codewrite/COBHouseLights/img/hardware-top-level.png

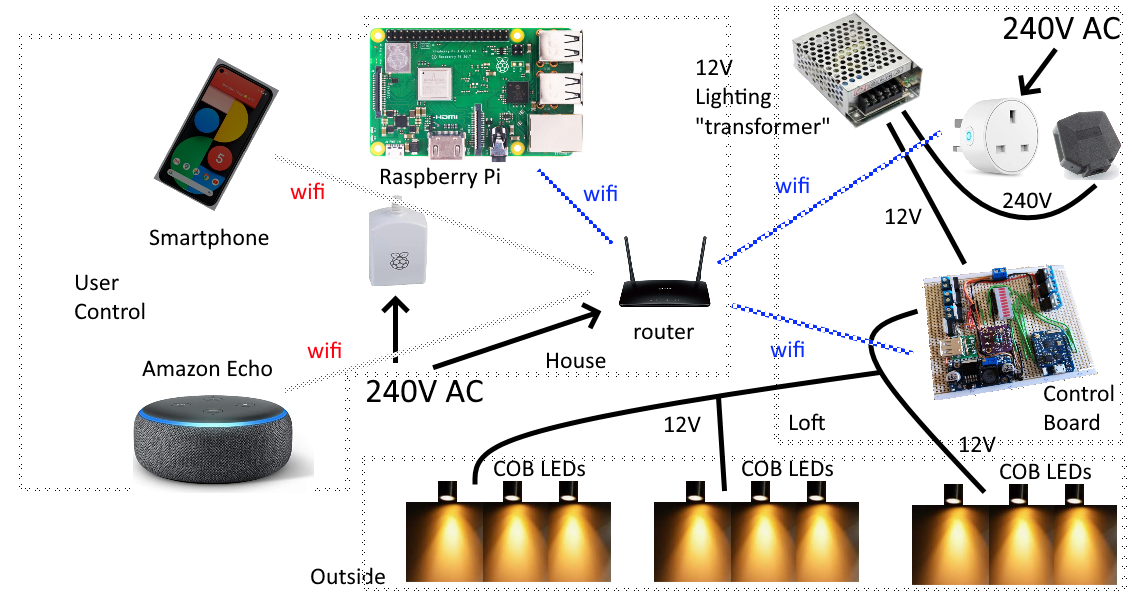
img/hardware-top-level.png
