codewrite/COBHouseLights/img/veroboard-test-setup.jpg

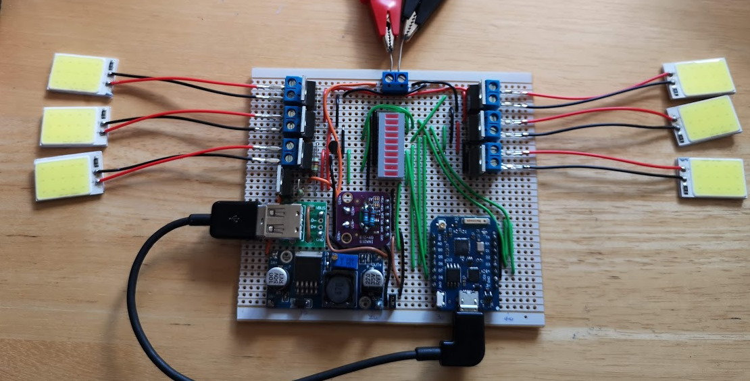
img/veroboard-test-setup.jpg
