codewrite/COBHouseLights/doc/ESP-Links.txt

https://randomnerdtutorials.com/esp32-esp8266-web-server-http-authentication/

>> ESP32 library missing WebServerSecure ?
https://github.com/espressif/arduino-esp32/issues/3902

https://github.com/esp8266/Arduino/tree/master/libraries/ESP8266WebServer/src
https://github.com/espressif/arduino-esp32/tree/master/libraries/WebServer/src

https://github.com/fhessel/esp32_https_server_compat/tree/3c3fe8479af06cc06e8db643acc81501217427bb/src

https://github.com/fhessel/esp32_https_server
https://www.dfrobot.com/blog-1255.html
