codewrite/COBHouseLights/img/veroboard1.jpg

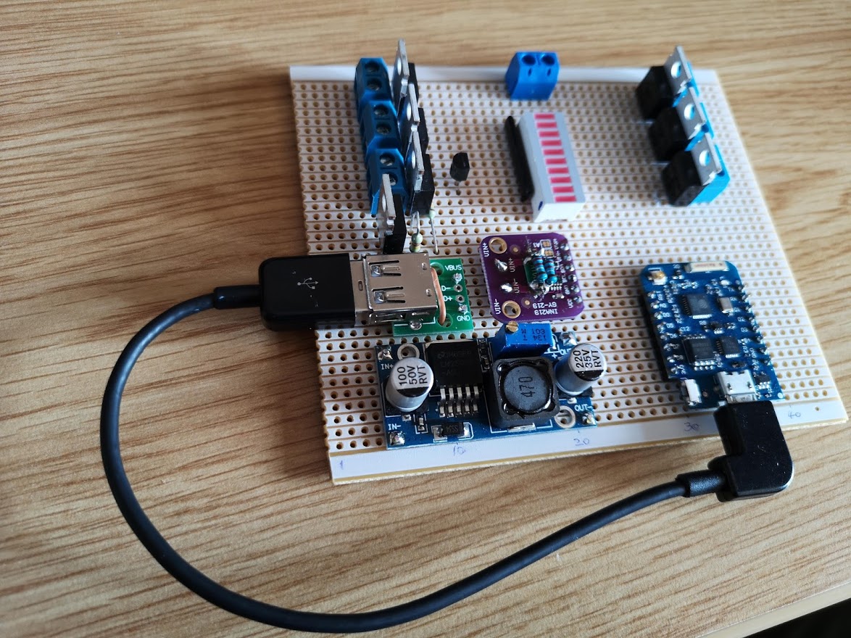
img/veroboard1.jpg
