codewrite/COBHouseLights/arduino/Veroboard-tests.xlsx

USB plugged into PC
 | Supply Voltage | Supply Current | LED1+ | LED1- | LED2+ | LED2- | LED3+ | LED3- | LED4+ | LED4- | LED5+ | LED5- | LED6+ | LED6-
pwr=0 | 12.1 | 0.006 | 0 | 0 | 0 | 0 | 0 | 0 | 0 | 0 | 0 | 0 | 0 | 0
Pwr=1 | 12.1 | 0.006 | 12.1 | 5.15 | 12.1 | 5.15 | 12.1 | 5.15 | 12.1 | 5.15 | 12.1 | 5.15 | 12.1 | 5.15
Voltage drop from rail (mV)
 |  |  | LED1+ | LED1- | LED2+ | LED2- | LED3+ | LED3- | LED4+ | LED4- | LED5+ | LED5- | LED6+ | LED6-
Pwr=1 | 11.95 | 0.191 | 25.2 | 8.4
 | 11.92 | 1.07 | 143.1 | 10 | 142.5 | 9.9 | 140.5 | 10.2 | 145 | 8.6 | 145.6 | 9.2 | 146.2 | 9.4
