codewrite/COBHouseLights/img-src/PChan-Mosfet-driver-redesigned.asc

C1: polcap; 10µ; V=10 Irms=2.21565 Rser=0.055 Lser=0 mfg="KEMET" pn="A700V106M010ATE055" type="Al electrolytic"
D1: zener; BZX84B9V1L
D2: diode; 1N4148
M1: pmos; IRF4905
M2: nmos; 2N7002
R1: res; 4R7
R2: res; 10K
R3: res; 220K
R4: res; 220K
V1: voltage; 12; Rser=1m
V2: voltage; PWL(0 0 1u 3.3 1 3.3 1.000001 0 1.5 0 1.500001 3.3 2 3.3 2.000001 0 2.2 0 2.200001 3.3 7 3.3 7.000001 0 8 0); Rser=10
Named nets: 0, IN, GATE, OUT
.inc irf4905.spi
.tran 8
COB Lights
