codewrite/COBHouseLights/img-src/COBHouseLights.asc

C2: polcap; 10µ; V=25 Irms=50m Rser=1.746 Lser=83.1619n mfg="Würth Elektronik" pn="860010472002 WCAP-ATG8 5x11" type="Al electrolytic"
D1: LED
D2: LED
D3: LED
D4: LED
D5: LED
D6: LED
D7: diode; 1N4148
I1: Connector
I2: Connector
I3: Connector
I4: Connector
I5: Connector
I6: Connector
M1: nmos; 2N7000
M2: pmos; IRF4905
M3: nmos; IRFZ44N
M4: nmos; IRFZ44N
M5: nmos; IRFZ44N
M6: nmos; IRFZ44N
M7: nmos; IRFZ44N
M8: nmos; IRFZ44N
R1: res; 100K
R2: res; 100K
R3: res; 4K7
R4: res; 4K7
R5: res; 4K7
R6: res; 4K7
R7: res; 4K7
R8: res; 4K7
R9: res; 1MegA
U1: WemosD1-mini-pro
U2: DC-DC-Converter
U3: USB
U4: INA219
V1: voltage; 12V
Named nets: D3, D4, D5, D6, D7, D8, TP1, TP4, TP2, TP9, TP10, TP5, TP3, TP6, TP8, TP7, TP11, TP12, TP13, 0
Mains to 12V 5A
COB LEDs connected to I1..I6 (in parallel).
Maximum number of LEDs is 30, for instance:
3 on I1, 2 on I2, 4 on I3, I4 and I5 and 13 on I6
INA219 is used to measure current.
0.1 ohm resistor in parallel with shunt resistor
allows current measurement up to about 5.4A.
If the current exceeds 5A (e.g. because of
a short in the wiring) the power can be shut
down by setting D0 low, which will turn off
MOSFET M2.
