codewrite/COBHouseLights/img-src/PChan-Mosfet-driver-original.asc

M1: pmos; IRF4905
M2: nmos; 2N7002
R1: res; 4R7
R2: res; 220K
R3: res; 220K
V1: voltage; 12; Rser=10m
V2: voltage; PWL(0 0 1u 3.3 1 3.3 1.000001 0 1.5 0 1.500001 3.3 2 3.3 2.000001 0 2.2 0 2.200001 3.3 7 3.3 7.000001 0 8 0); Rser=1
Named nets: 0, IN, GATE, OUT
.inc irf4905.spi
.tran 8
COB Lights
PULSE(0 3.3 100m 5n 5n 100m 200m)
