codewrite/COBHouseLights/(commit log)

2021-05-24 Minor arduino code changes and docs
2021-05-31 Minor changes - swagger and schematics
2021-06-01 Add ESP32 support
2021-10-06 Add status and current limiting
2021-10-08 Use average current for status. V3 of esp8266 library defaults to 256, so change to 1023
